putsolardynamics/Telemetry-Module/Docs/Renders/RF_module_3D_render.jpg

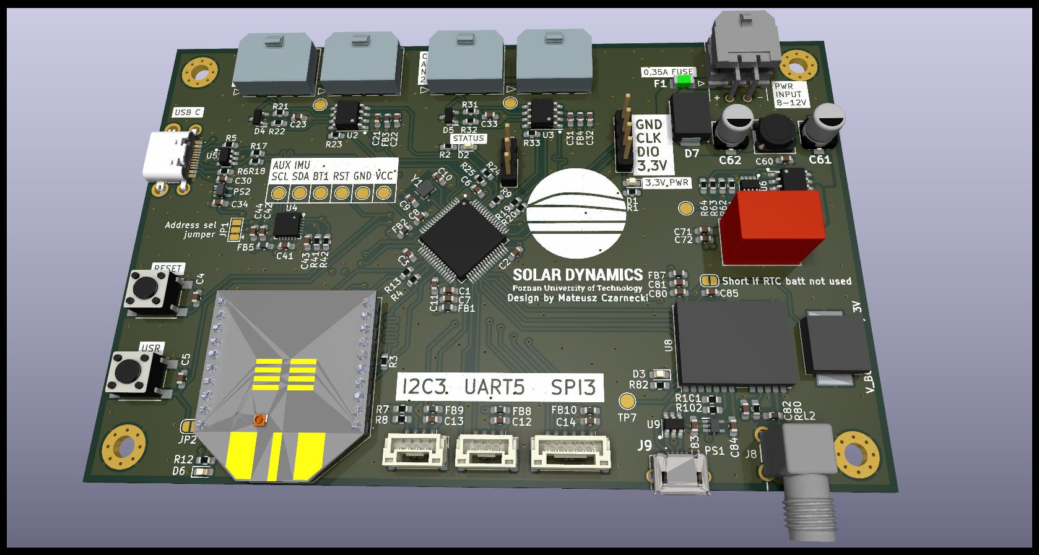
Docs/Renders/RF_module_3D_render.jpg
