putsolardynamics/Telemetry-Module/Docs/Renders/RF_module_2D_back.jpg

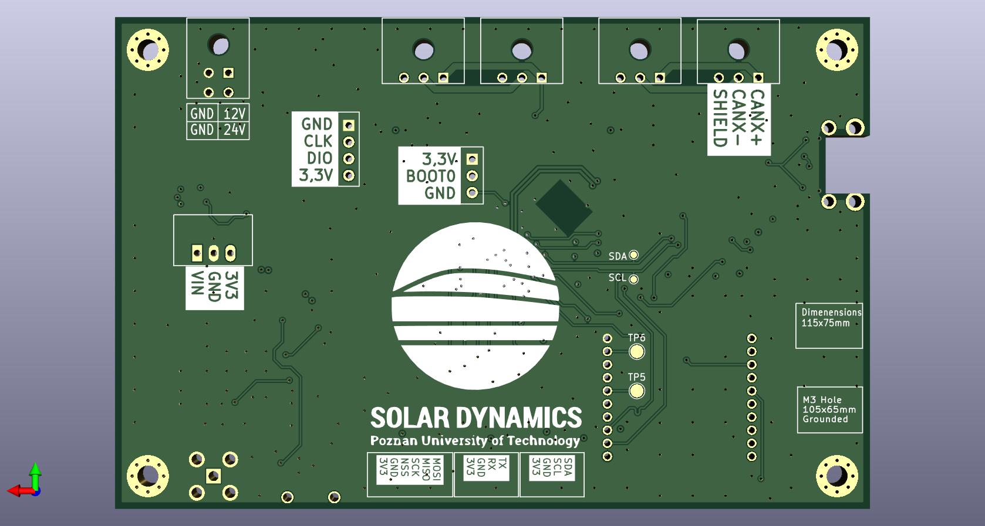
Docs/Renders/RF_module_2D_back.jpg
