putsolardynamics/Telemetry-Module/Docs/Renders/RF_module_2D_front.jpg

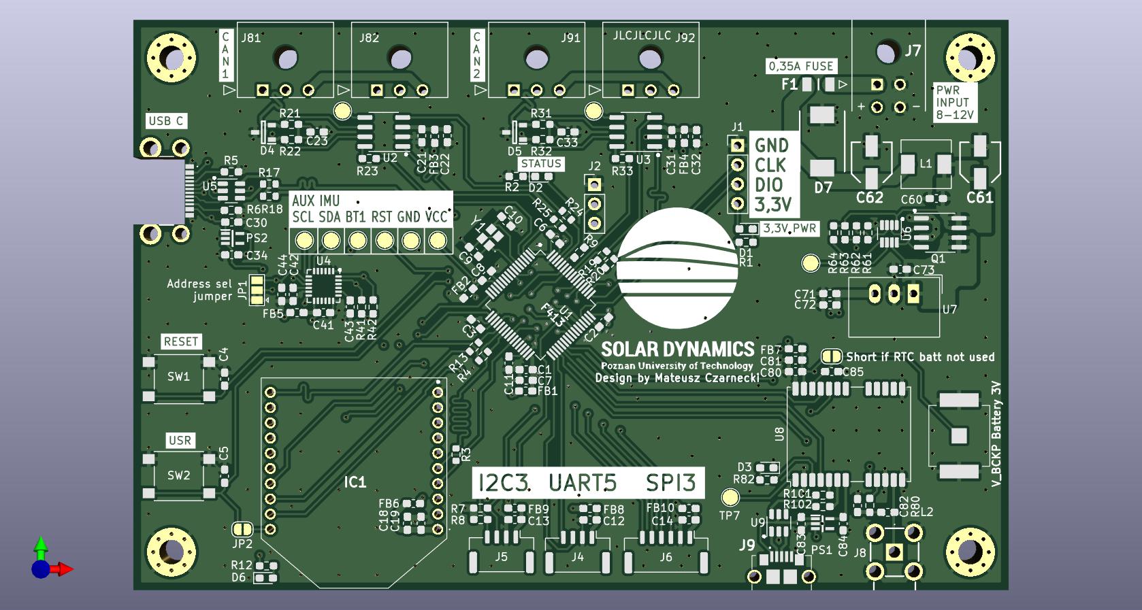
Docs/Renders/RF_module_2D_front.jpg
