putsolardynamics/Telemetry-Module/Docs/Schematics/RF_module.pdf

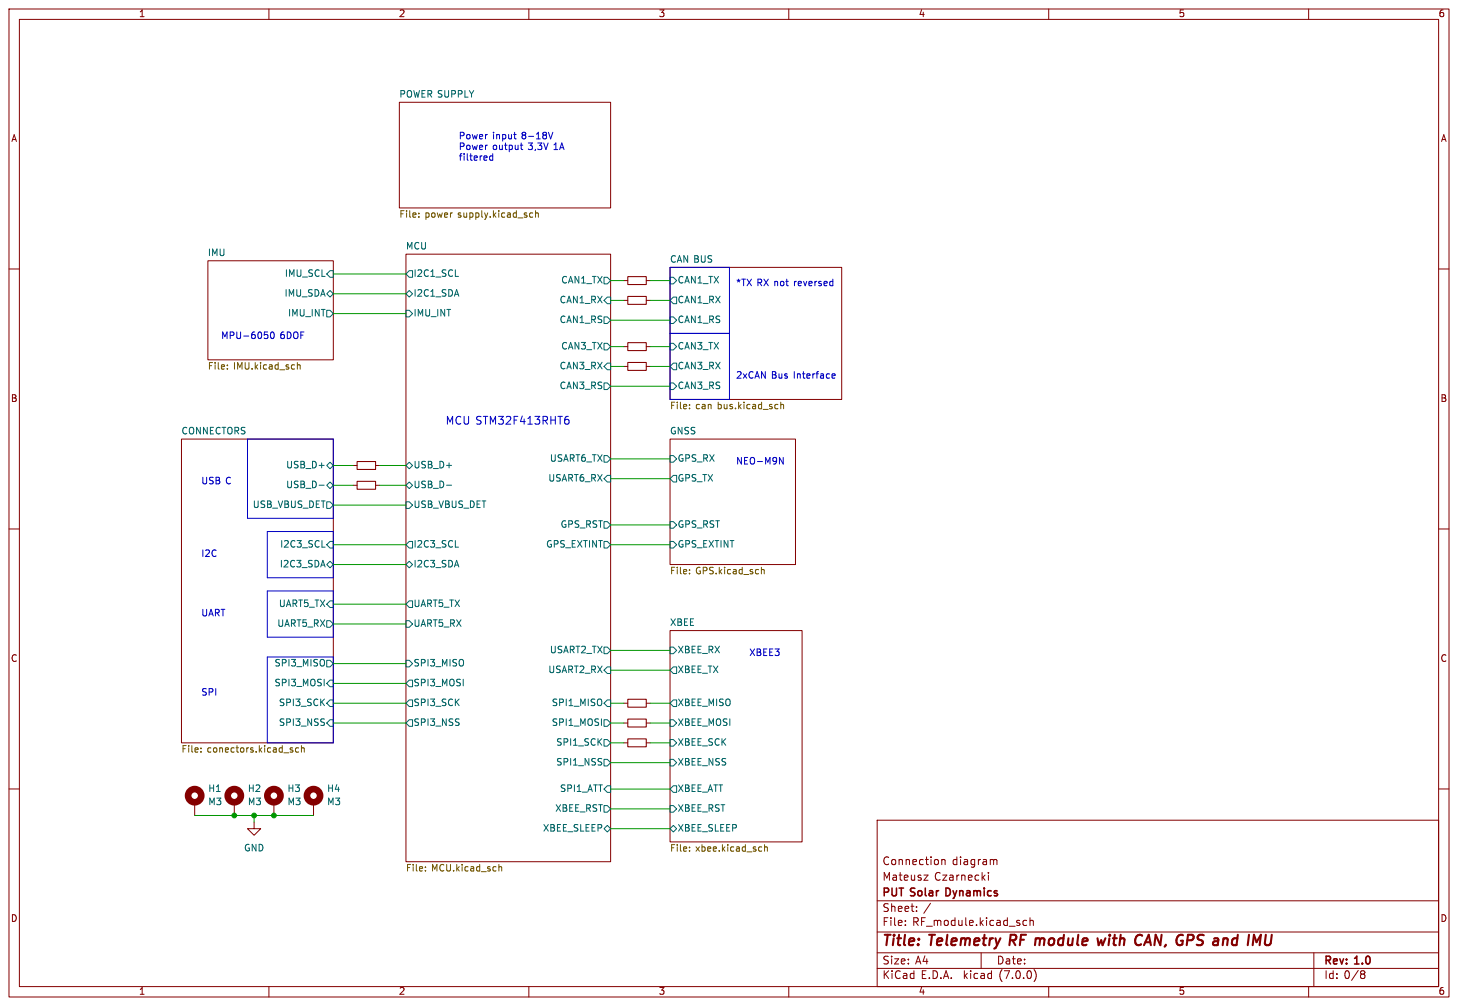
[picture p4: page 1]

File: can bus.kicad_sch POWER SUPPLY

*TX RX not reversed Power input 8-18V
Power output 3,3V 1A
SPI3_NSS USB_D+ UART5_TX UART5_RX MCU
File: GPS.kicad_sch CAN1_RS CAN1_RX CAN1_TX CAN3_RS CAN3_RX CAN3_TX CAN BUS
CAN3_TX CAN1_RX CAN1_TX CAN3_RX

2xCAN Bus Interface MCU STM32F413RHT6 UART SPI
I2C3_SCL USB_D+ USB_D- SPI3_MISO

Id: 0/8 Title: Telemetry RF module with CAN, GPS and IMU

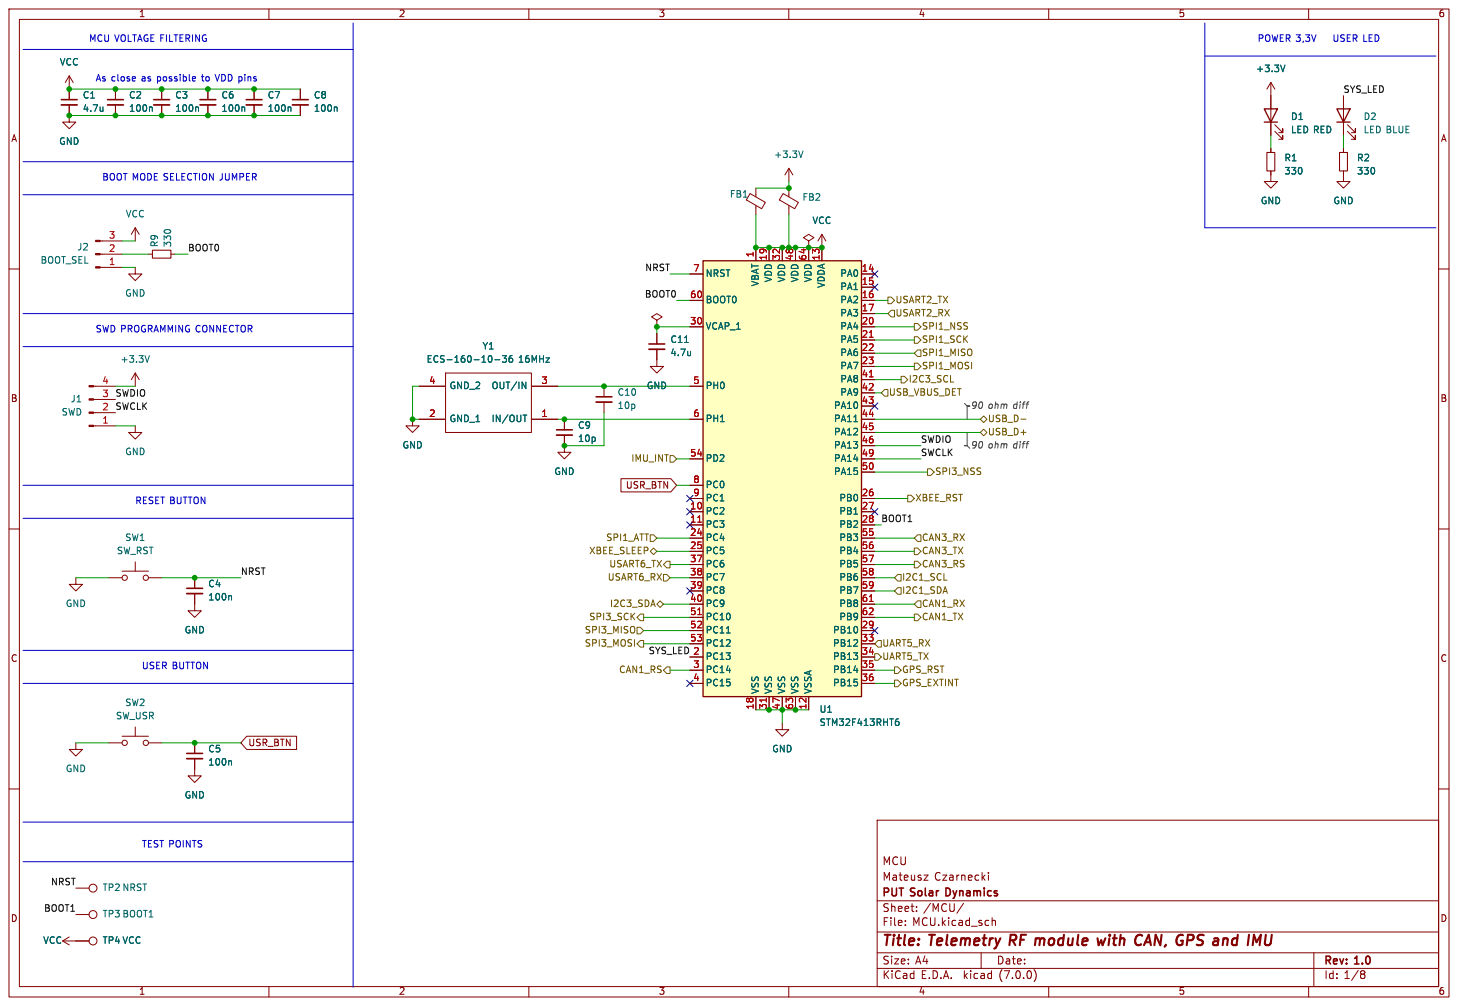
[picture p5: page 2]

BOOT MODE SELECTION JUMPER MCU VOLTAGE FILTERING
100n GND

As close as possible to VDD pins SWD PROGRAMMING CONNECTOR

1 PC2 10 PC3 11 VSSA 12 VDDA 13 PA0 14 PA1 15 PA2 16 PA3 17 VSS 18 VDD 19 PC13 2 PA4 20 PA5 21 PA6 22 PA7 23 PC4 24 PC5 25 PB0 26 PB1 27 PB2 28 PB10 29 PC14 3 VCAP_1 30 VSS 31 VDD 32 PB12 33 PB13 34 PB14 35 PB15 36 PC6 37 PC7 38 PC8 39 PC15 4 PC9 40 PA8 41 PA9 42 PA10 43 PA11 44 PA12 45 PA13 46 VSS 47 VDD 48 PA14 49 PH0 5 PA15 50 PC10 51 PC11 52 PC12 53 PD2 54 PB3 55 PB4 56 PB5 57 PB6 58 PB7 59 PH1 6 BOOT0 60 PB8 61 PB9 62 VSS 63 VDD 64 NRST 7 PC0 8 PC1 9 U1STM32F413RHT6 +3.3V GND

1 PC2 10 PC3 11 VSSA 12 VDDA 13 PA0 14 PA1 15 PA2 16 PA3 17 VSS 18 VDD 19 PC13 2 PA4 20 PA5 21 PA6 22 PA7 23 PC4 24 PC5 25 PB0 26 PB1 27 PB2 28 PB10 29 PC14 3 VCAP_1 30 VSS 31 VDD 32 PB12 33 PB13 34 PB14 35 PB15 36 PC6 37 PC7 38 PC8 39 PC15 4 PC9 40 PA8 41 PA9 42 PA10 43 PA11 44 PA12 45 PA13 46 VSS 47 VDD 48 PA14 49 PH0 5 PA15 50 PC10 51 PC11 52 PC12 53 PD2 54 PB3 55 PB4 56 PB5 57 PB6 58 PB7 59 PH1 6 BOOT0 60 PB8 61 PB9 62 VSS 63 VDD 64 NRST 7 PC0 8 PC1 9 C9

Id: 1/8 Title: Telemetry RF module with CAN, GPS and IMU

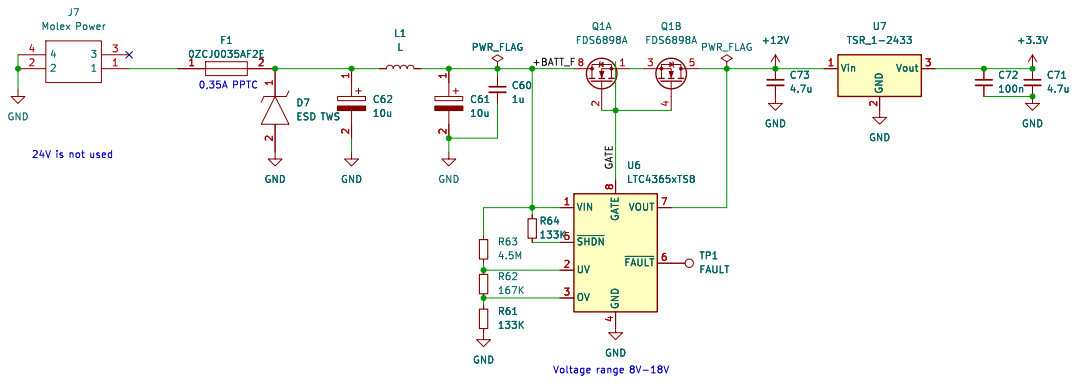
[picture p6: page 3]

4 ~{SHDN} 5 ~{FAULT}6 VOUT 7 GATE

Id: 2/8 Title: Telemetry RF module with CAN, GPS and IMU

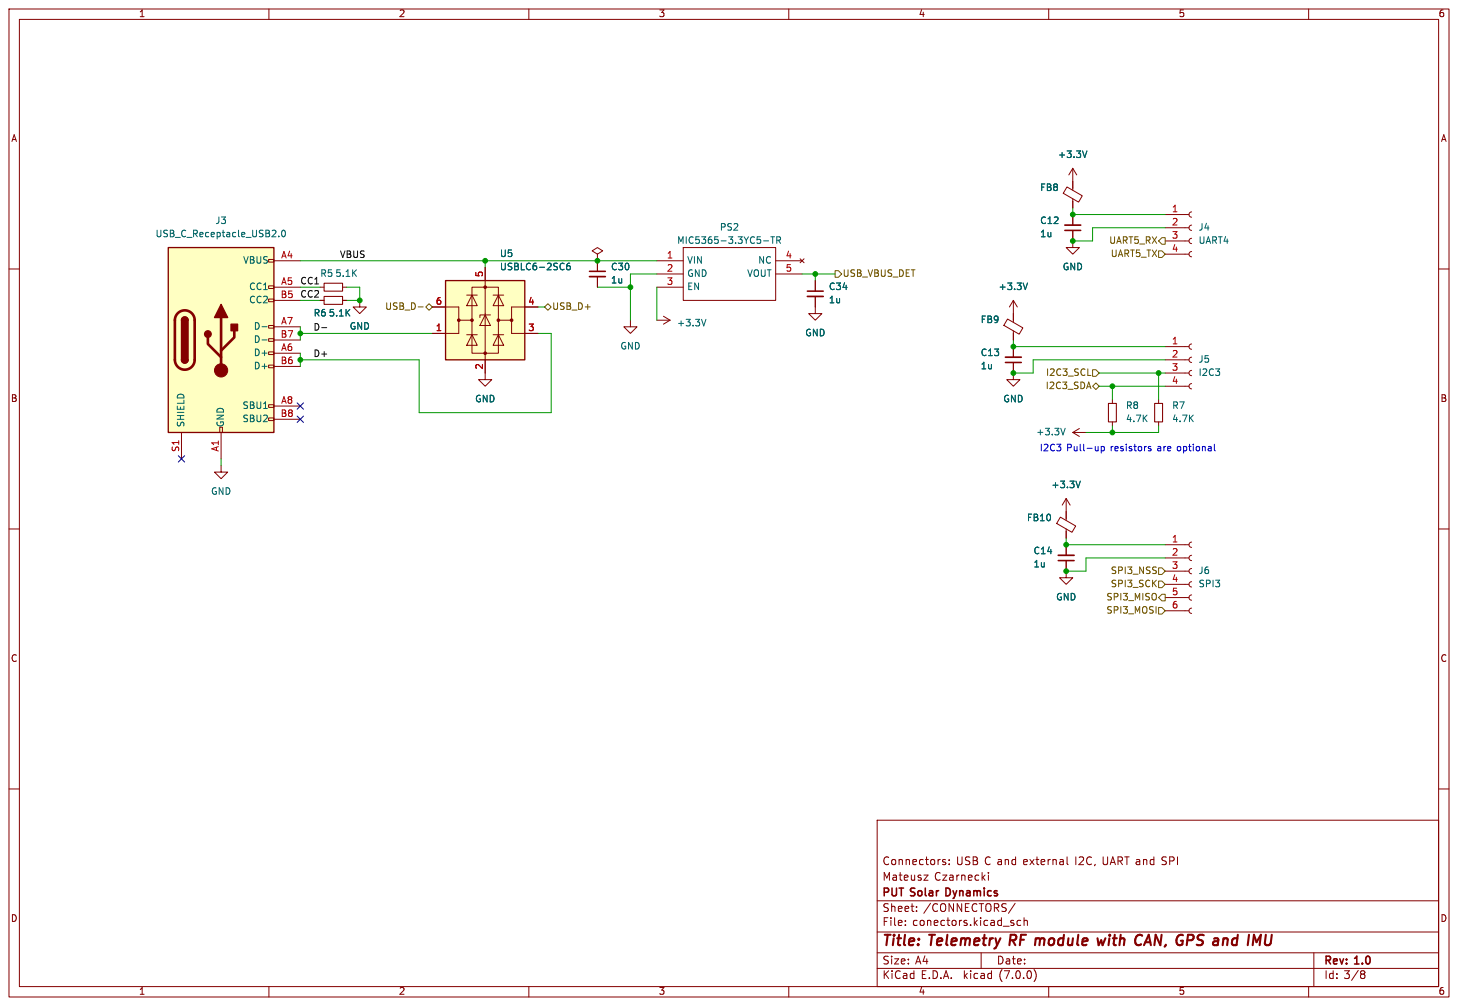
[picture p7: page 4]

Id: 3/8 Title: Telemetry RF module with CAN, GPS and IMU

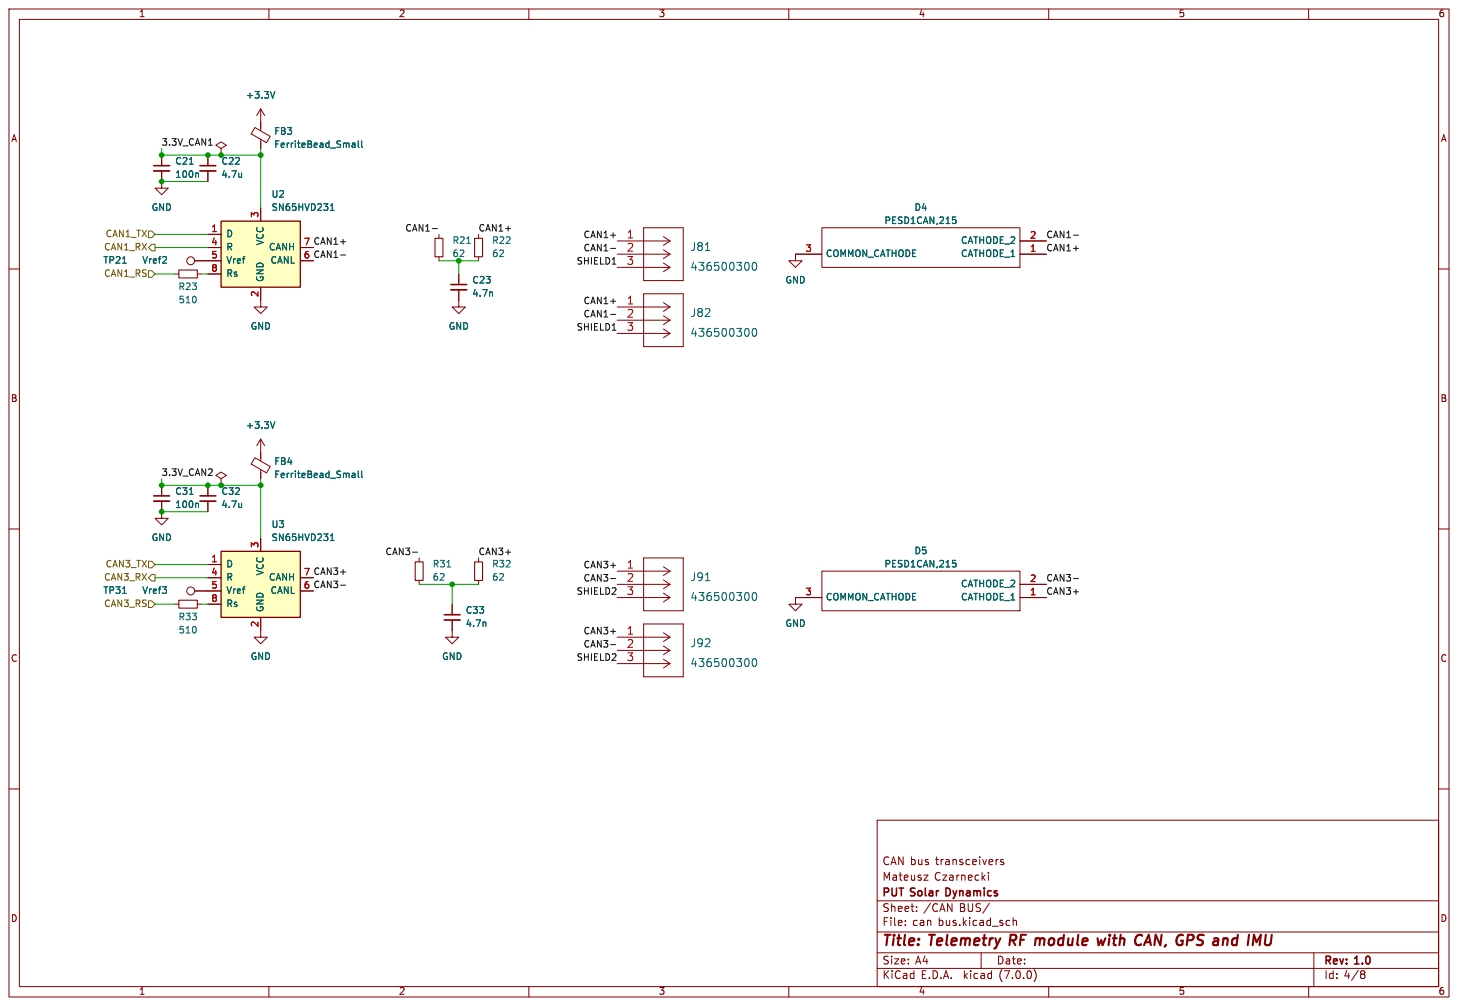
[picture p8: page 5]

Id: 4/8 Title: Telemetry RF module with CAN, GPS and IMU

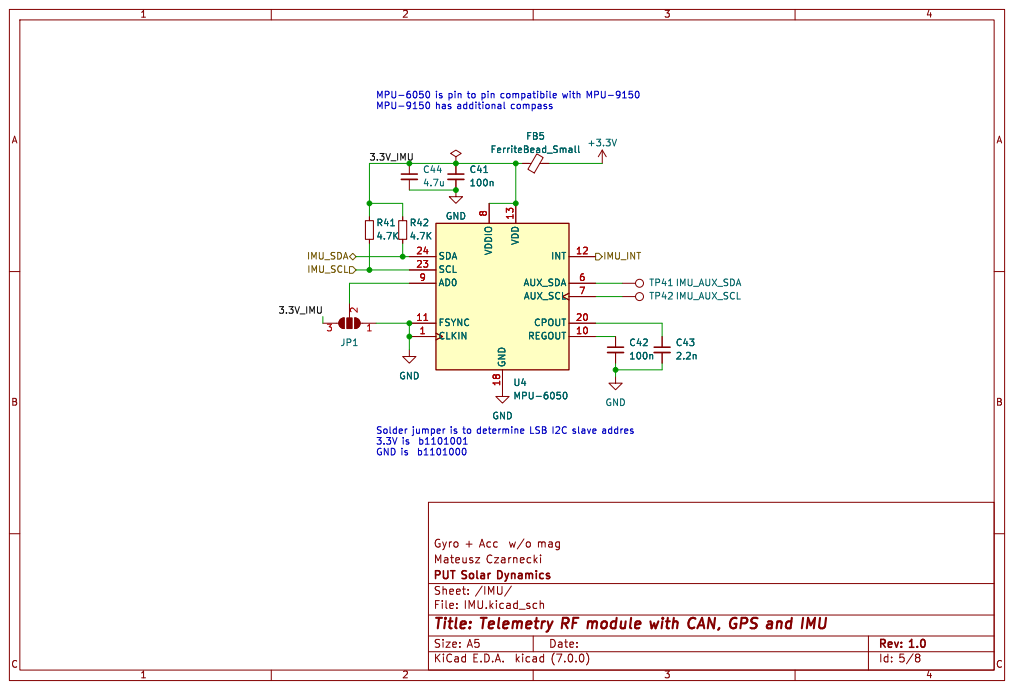
[picture p9: page 6]

Id: 5/8 Title: Telemetry RF module with CAN, GPS and IMU

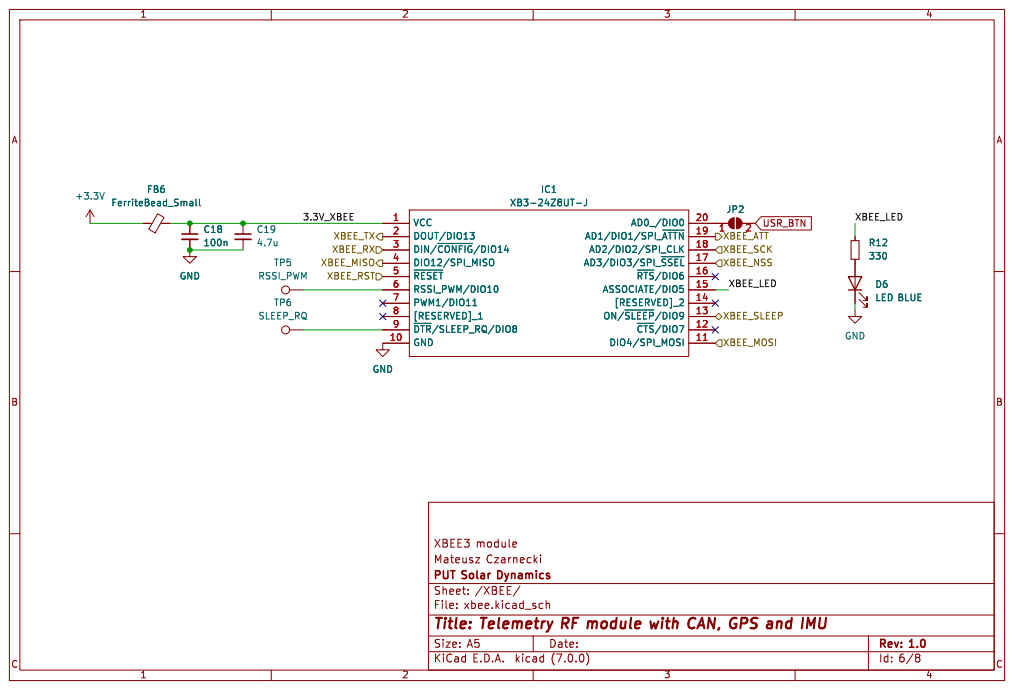
[picture p10: page 7]

Id: 6/8 Title: Telemetry RF module with CAN, GPS and IMU

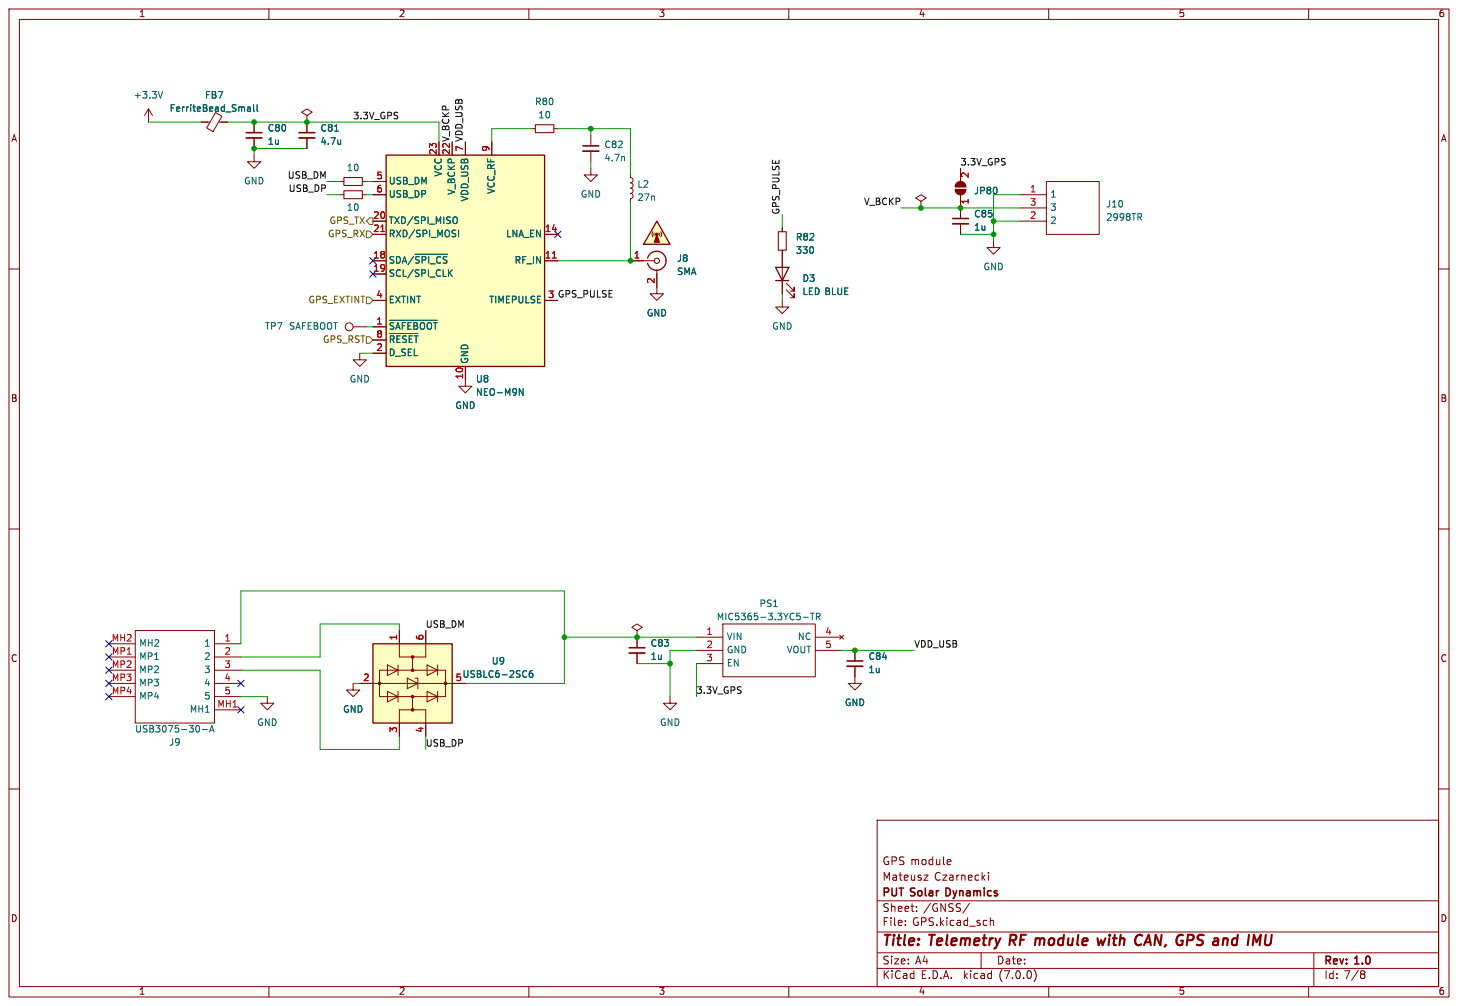
[picture p11: page 8]

Id: 7/8 Title: Telemetry RF module with CAN, GPS and IMU
