putsolardynamics/Telemetry-Module/Hardware/RF_module/RF_module.kicad_pcb

## KiCad design Hardware/RF_module/RF_module.kicad_pcb (2023-03-06)

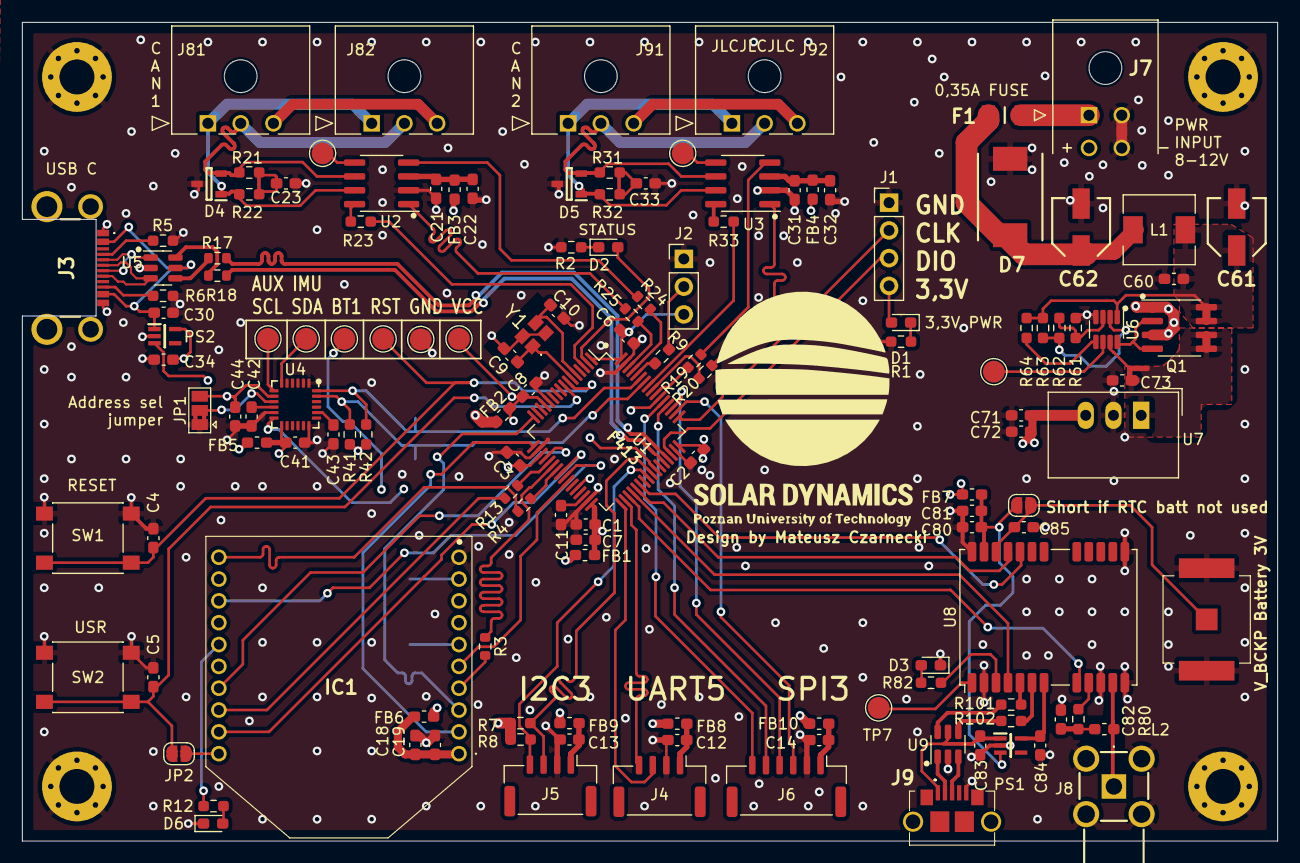
[picture p12: board RF_module.kicad_pcb from above]

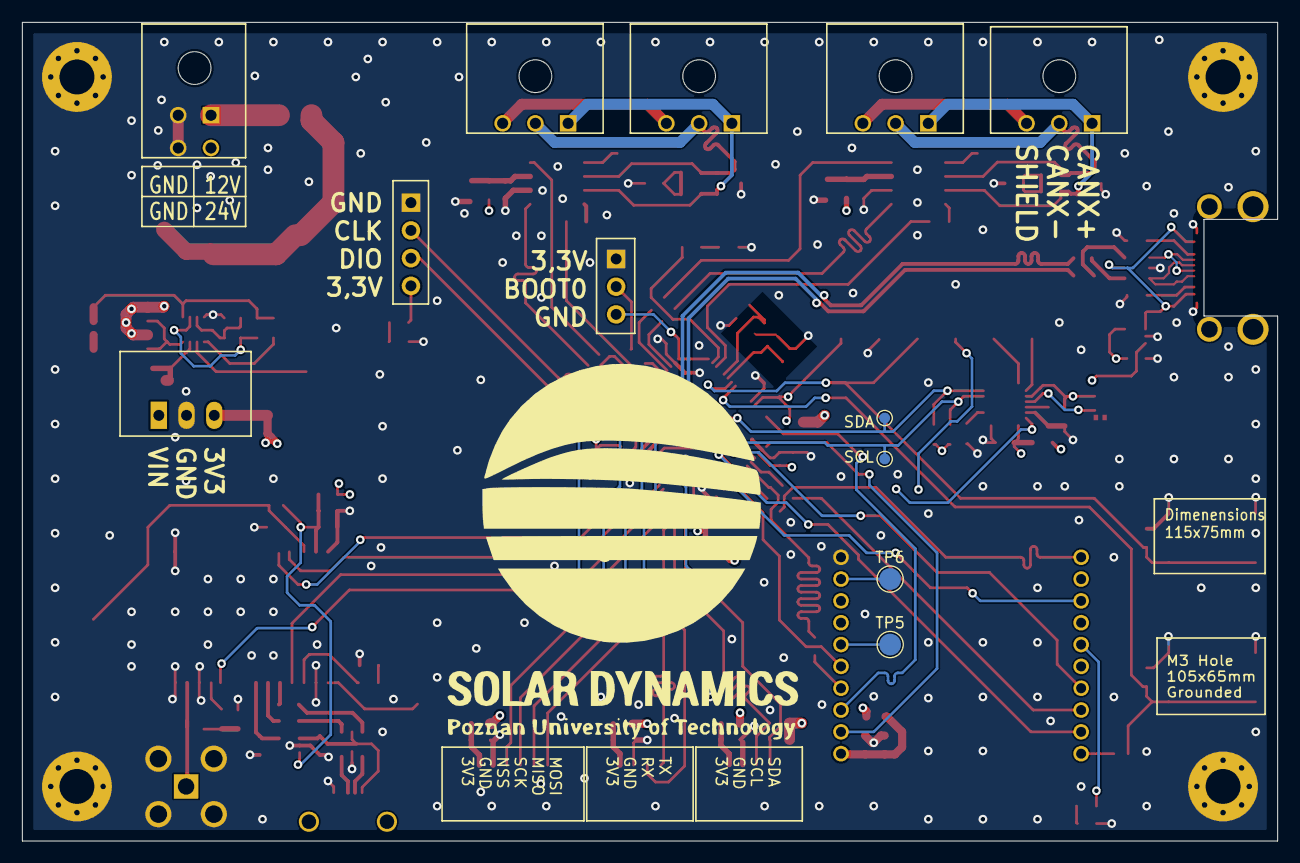
[picture p13: board RF_module.kicad_pcb from below]

Board: 4 copper layers, 115.0 x 75.0 mm, 144 parts (4 on the bottom side), 118 nets.

Parts:
C1, C11, C19, C22, C32, C44, C71, C73, C81: 4.7u; C_0603_1608Metric_Pad1.08x0.95mm_HandSolder
C2, C3, C4, C5, C6, C7, C8, C18, C21, C31, C41, C42, C72: 100n; C_0603_1608Metric_Pad1.08x0.95mm_HandSolder
C9, C10: 10p; C_0603_1608Metric_Pad1.08x0.95mm_HandSolder
C12, C13, C14, C30, C34, C60, C80, C83, C84, C85: 1u; C_0603_1608Metric_Pad1.08x0.95mm_HandSolder
C23, C33, C82: 4.7n; C_0603_1608Metric_Pad1.08x0.95mm_HandSolder
C43: 2.2n; C_0603_1608Metric_Pad1.08x0.95mm_HandSolder
C61, C62: 10u; EEE0GA101SR
D1: LED RED; LED_0603_1608Metric_Pad1.05x0.95mm_HandSolder
D2, D3, D6: LED BLUE; LED_0603_1608Metric_Pad1.05x0.95mm_HandSolder
D4, D5: PESD1CAN,215; SOT95P230X110-3N
D7: ESD TWS; DIONM7959X262N
F1: 0ZCJ0035AF2E; FUSC3216X130N
FB1, FB2, FB3, FB4, FB5, FB6, FB7, FB8, FB9, FB10: FerriteBead_Small; L_0603_1608Metric_Pad1.05x0.95mm_HandSolder
H1, H2, H3, H4: M3; MountingHole_3.2mm_M3_Pad_Via
IC1: XB3-24Z8UT-J; XB324Z8UTJ
J1: SWD; PinHeader_1x04_P2.54mm_Vertical
J2: BOOT_SEL; PinHeader_1x03_P2.54mm_Vertical
J3: USB_C_Receptacle_USB2.0; USB4500030A
J4: UART4; JST_GH_BM04B-GHS-TBT_1x04-1MP_P1.25mm_Vertical
J5: I2C3; JST_GH_BM04B-GHS-TBT_1x04-1MP_P1.25mm_Vertical
J6: SPI3; JST_GH_BM06B-GHS-TBT_1x06-1MP_P1.25mm_Vertical
J7: Molex Power; 43045-04_00,01,02,10_
J8: SMA; 518144002
J9: USB3075-30-A; USB307530A
J10: 2998TR
J81, J82, J91, J92: 436500300
JP1: SolderJumper_3_Open; SolderJumper-3_P1.3mm_Bridged2Bar12_Pad1.0x1.5mm
JP2, JP80: SolderJumper_2_Open; SolderJumper-2_P1.3mm_Open_RoundedPad1.0x1.5mm
L1: L; L_6.3x6.3_H3
L2: 27n; L_0603_1608Metric_Pad1.05x0.95mm_HandSolder
PS1, PS2: MIC5365-3.3YC5-TR; SOT65P210X110-5N
Q1: FDS6898A; SOIC-8_3.9x4.9mm_P1.27mm
R1, R2, R9, R12, R82: 330; R_0603_1608Metric_Pad0.98x0.95mm_HandSolder
R3, R4, R13, R17, R18, R19, R20, R24, R25: 0; R_0603_1608Metric
R5, R6: 5.1K; R_0603_1608Metric_Pad0.98x0.95mm_HandSolder
R7, R8, R41, R42: 4.7K; R_0603_1608Metric_Pad0.98x0.95mm_HandSolder
R21, R22, R31, R32: 62; R_0603_1608Metric_Pad0.98x0.95mm_HandSolder
R23, R33: 510; R_0603_1608Metric_Pad0.98x0.95mm_HandSolder
R61, R64: 133K; R_0603_1608Metric_Pad0.98x0.95mm_HandSolder
R62: 167K; R_0603_1608Metric_Pad0.98x0.95mm_HandSolder
R63: 4.5M; R_0603_1608Metric_Pad0.98x0.95mm_HandSolder
R80, R101, R102: 10; R_0603_1608Metric_Pad0.98x0.95mm_HandSolder
SW1: SW_RST; SW_Push_1P1T_NO_6x6mm_H9.5mm
SW2: SW_USR; SW_Push_1P1T_NO_6x6mm_H9.5mm
TP1: FAULT; TestPoint_Pad_D2.0mm
TP2: NRST; TestPoint_Pad_D2.0mm
TP3: BOOT1; TestPoint_Pad_D2.0mm
TP4: VCC; TestPoint_Pad_D2.0mm
TP5: RSSI_PWM; TestPoint_Pad_D2.0mm
TP6: SLEEP_RQ; TestPoint_Pad_D2.0mm
TP7: SAFEBOOT; TestPoint_Pad_D2.0mm
TP21: Vref2; TestPoint_Pad_D2.0mm
TP31: Vref3; TestPoint_Pad_D2.0mm
TP41: IMU_AUX_SDA; TestPoint_Pad_D2.0mm
TP42: IMU_AUX_SCL; TestPoint_Pad_D2.0mm
TP234: GND; TestPoint_Pad_D2.0mm
TP_SDA: TestPoint_Pad_D1.0mm
TP_SDA#2: TestPoint_Pad_D1.0mm
U1: STM32F413RHT6; LQFP-64_10x10mm_P0.5mm
U2, U3: SN65HVD231; SOIC-8_3.9x4.9mm_P1.27mm
U4: MPU-6050; InvenSense_QFN-24_4x4mm_P0.5mm
U5, U9: USBLC6-2SC6; SOT-23-6
U6: LTC4365xTS8; TSOT-23-8
U7: TSR_1-2433; Converter_DCDC_TRACO_TSR-1_THT
U8: NEO-M9N; ublox_NEO
Y1: ECS-160-10-36 16MHz; ECS1601036CKMTR3

Connections:
+3.3V: C71.1, C72.1, D1.2 (A), FB1.1, FB2.1, FB3.1, FB4.1, FB5.2, FB6.1, FB7.1, FB8.1, FB9.1, FB10.1, J1.4, PS2.3 (EN), R7.1, R8.1, U7.3 (Vout)
+12V: C73.1, Q1.5 (D2), Q1.6 (D2), U6.7 (VOUT), U7.1 (Vin)
/CAN BUS/3.3V_CAN1: C21.1, C22.1, FB3.2, U2.3 (VCC)
/CAN BUS/3.3V_CAN2: C31.1, C32.1, FB4.2, U3.3 (VCC)
/CAN BUS/CAN1+: D4.1 (CATHODE_1), J81.1, J82.1, R22.1, U2.7 (CANH)
/CAN BUS/CAN1-: D4.2 (CATHODE_2), J81.2, J82.2, R21.1, U2.6 (CANL)
/CAN BUS/CAN1_RS: R23.2, U1.3 (PC14)
/CAN BUS/CAN1_RX: R24.2, U2.4 (R)
/CAN BUS/CAN1_TX: R25.2, U2.1 (D)
/CAN BUS/CAN3+: D5.1 (CATHODE_1), J91.1, J92.1, R32.1, U3.7 (CANH)
/CAN BUS/CAN3-: D5.2 (CATHODE_2), J91.2, J92.2, R31.1, U3.6 (CANL)
/CAN BUS/CAN3_RS: R33.2, U1.57 (PB5)
/CAN BUS/CAN3_RX: R19.2, U3.4 (R)
/CAN BUS/CAN3_TX: R20.2, U3.1 (D)
/CAN BUS/SHIELD1: J81.3, J82.3
/CAN BUS/SHIELD2: J91.3, J92.3
/CONNECTORS/CC1: J3.A5 (CC1), R5.1
/CONNECTORS/CC2: J3.B5 (CC2), R6.1
/CONNECTORS/D+: J3.A6 (D+), J3.B6 (D+), U5.3 (I/O2)
/CONNECTORS/D-: J3.A7 (D-), J3.B7 (D-), U5.1 (I/O1)
/CONNECTORS/I2C3_SCL: J5.3, R7.2, U1.41 (PA8)
/CONNECTORS/I2C3_SDA: J5.4, R8.2, U1.40 (PC9)
/CONNECTORS/SPI3_MISO: J6.5, U1.52 (PC11)
/CONNECTORS/SPI3_MOSI: J6.6, U1.53 (PC12)
/CONNECTORS/SPI3_NSS: J6.3, U1.50 (PA15)
/CONNECTORS/SPI3_SCK: J6.4, U1.51 (PC10)
/CONNECTORS/UART5_RX: J4.3, U1.33 (PB12)
/CONNECTORS/UART5_TX: J4.4, U1.34 (PB13)
/CONNECTORS/USB_D+: R17.1, U5.4 (I/O2)
/CONNECTORS/USB_D-: R18.1, U5.6 (I/O1)
/CONNECTORS/USB_VBUS_DET: C34.1, PS2.5 (VOUT), U1.42 (PA9)
/CONNECTORS/VBUS: C30.1, J3.A4 (VBUS), J3.A9 (VBUS), PS2.1 (VIN), U5.5 (VBUS)
/GNSS/3.3V_GPS: C80.1, C81.1, FB7.2, JP80.2 (B), PS1.3 (EN), U8.23 (VCC)
/GNSS/GPS_EXTINT: U1.36 (PB15), U8.4 (EXTINT)
/GNSS/GPS_PULSE: R82.1, U8.3 (TIMEPULSE)
/GNSS/GPS_RST: U1.35 (PB14), U8.8 (~RESET)
/GNSS/GPS_RX: U1.37 (PC6), U8.21 (RXD/SPI_MOSI)
/GNSS/GPS_TX: U1.38 (PC7), U8.20 (TXD/SPI_MISO)
/GNSS/USB_DM: R101.1, U9.6 (I/O1)
/GNSS/USB_DP: R102.1, U9.4 (I/O2)
/GNSS/VDD_USB: C84.1, PS1.5 (VOUT), U8.7 (VDD_USB)
/GNSS/V_BCKP: C85.1, J10.3, JP80.1 (A), U8.22 (V_BCKP)
/IMU/3.3V_IMU: C41.1, C44.1, FB5.1, JP1.3 (B), R41.1, R42.1, U4.8 (VDDIO), U4.13 (VDD)
/IMU/IMU_INT: U1.54 (PD2), U4.12 (INT)
/IMU/IMU_SCL: R41.2, TP_SDA.1, U1.58 (PB6), U4.23 (SCL)
/IMU/IMU_SDA: R42.2, TP_SDA#2.1, U1.59 (PB7), U4.24 (SDA)
/MCU/BOOT0: R9.2, U1.60 (BOOT0)
/MCU/BOOT1: TP3.1, U1.28 (PB2)
/MCU/CAN1_RX: R24.1, U1.61 (PB8)
/MCU/CAN1_TX: R25.1, U1.62 (PB9)
/MCU/CAN3_RX: R19.1, U1.55 (PB3)
/MCU/CAN3_TX: R20.1, U1.56 (PB4)
/MCU/NRST: C4.1, SW1.2, TP2.1, U1.7 (NRST)
/MCU/SPI1_ATT: IC1.19 (AD1/DIO1/SPI_~ATTN), U1.24 (PC4)
/MCU/SPI1_MISO: R3.1, U1.22 (PA6)
/MCU/SPI1_MOSI: R4.1, U1.23 (PA7)
/MCU/SPI1_NSS: IC1.17 (AD3/DIO3/SPI_~SSEL), U1.20 (PA4)
/MCU/SPI1_SCK: R13.1, U1.21 (PA5)
/MCU/SWCLK: J1.2, U1.49 (PA14)
/MCU/SWDIO: J1.3, U1.46 (PA13)
/MCU/SYS_LED: D2.2 (A), U1.2 (PC13)
/MCU/USART2_RX: IC1.2 (DOUT/DIO13), U1.17 (PA3)
/MCU/USART2_TX: IC1.3 (DIN/~CONFIG/DIO14), U1.16 (PA2)
/MCU/USB_D+: R17.2, U1.45 (PA12)
/MCU/USB_D-: R18.2, U1.44 (PA11)
/MCU/XBEE_RST: IC1.5 (~RESET), U1.26 (PB0)
/MCU/XBEE_SLEEP: IC1.13 (ON/~SLEEP/DIO9), U1.25 (PC5)
/POWER SUPPLY/+BATT_F: C60.1, C61.1, L1.2, Q1.7 (D1), Q1.8 (D1), R63.1, R64.1, U6.1 (VIN)
/POWER SUPPLY/GATE: Q1.2 (G1), Q1.4 (G2), U6.8 (GATE)
/XBEE/3.3V_XBEE: C18.1, C19.1, FB6.2, IC1.1 (VCC)
/XBEE/XBEE_LED: IC1.15 (ASSOCIATE/DIO5), R12.1
/XBEE/XBEE_MISO: IC1.4 (DIO12/SPI_MISO), R3.2
/XBEE/XBEE_MOSI: IC1.11 (DIO4/SPI_MOSI), R4.2
/XBEE/XBEE_SCK: IC1.18 (AD2/DIO2/SPI_CLK), R13.2
GND: C1.2, C2.2, C3.2, C4.2, C5.2, C6.2, C7.2, C8.2, C9.2, C10.2, C11.2, C12.1, C13.1, C14.1, C18.2, C19.2, C21.2, C22.2, C23.2, C30.2, C31.2, C32.2, C33.2, C34.2, C41.2, C42.2, C43.2, C44.2, C60.2, C61.2, C62.2, C71.2, C72.2, C73.2, C80.2, C81.2, C82.2, C83.2, C84.2, C85.2, D3.1 (K), D4.3 (COMMON_CATHODE), D5.3 (COMMON_CATHODE), D6.1 (K), D7.2, H1.1, H2.1, H3.1, H4.1, IC1.10 (GND), J1.1, J2.1, J3.A1 (GND), J3.A12 (GND), J4.2, J5.2, J6.2, J7.2, J7.4, J8.2 (Ext), J9.5, J10.1, J10.2, JP1.1 (A), PS1.2 (GND), PS2.2 (GND), R1.2, R2.2, R5.2, R6.2, R61.2, SW1.1, SW2.1, TP234.1, U1.12 (VSSA), U1.18 (VSS), U1.31 (VSS), U1.47 (VSS), U1.63 (VSS), U2.2 (GND), U3.2 (GND), U4.1 (CLKIN), U4.11 (FSYNC), U4.18 (GND), U5.2 (GND), U6.4 (GND), U7.2 (GND), U8.2 (D_SEL), U8.10 (GND), U8.12 (GND), U8.13 (GND), U8.24 (GND), U9.2 (GND), Y1.2 (GND_1), Y1.4 (GND_2)
unnamed: C23.1, R21.2, R22.2
unnamed: C33.1, R31.2, R32.2
unnamed: C62.1, D7.1, F1.2, L1.1
unnamed: C82.1, L2.1, R80.2
unnamed: D1.1 (K), R1.1
unnamed: D2.1 (K), R2.1
unnamed: D3.2 (A), R82.2
unnamed: D6.2 (A), R12.2
unnamed: F1.1, J7.1
unnamed: IC1.20 (AD0_/DIO0), JP2.1 (A)
unnamed: IC1.6 (RSSI_PWM/DIO10), TP5.1
unnamed: IC1.9 (~DTR/SLEEP_RQ/DIO8), TP6.1
unnamed: J2.2, R9.1
unnamed: C12.2, FB8.2, J4.1
unnamed: C13.2, FB9.2, J5.1
unnamed: C14.2, FB10.2, J6.1
unnamed: J8.1 (In), L2.2, U8.11 (RF_IN)
unnamed: J9.2, U9.1 (I/O1)
unnamed: J9.3, U9.3 (I/O2)
unnamed: JP1.2 (C), U4.9 (AD0)
unnamed: C83.1, J9.1, PS1.1 (VIN), U9.5 (VBUS)
unnamed: Q1.1 (S1), Q1.3 (S2)
unnamed: C10.1, U1.5 (PH0), Y1.3 (OUT/IN)
unnamed: C9.1, U1.6 (PH1), Y1.1 (IN/OUT)
unnamed: C11.1, U1.30 (VCAP_1)
unnamed: R23.1, U2.8 (Rs)
unnamed: TP21.1, U2.5 (Vref)
unnamed: R33.1, U3.8 (Rs)
unnamed: TP31.1, U3.5 (Vref)
unnamed: TP42.1, U4.7 (AUX_SCL)
unnamed: TP41.1, U4.6 (AUX_SDA)
unnamed: C43.1, U4.20 (CPOUT)
unnamed: C42.1, U4.10 (REGOUT)
unnamed: R61.1, R62.1, U6.3 (OV)
unnamed: R62.2, R63.2, U6.2 (UV)
unnamed: TP1.1, U6.6 (~FAULT)
unnamed: R64.2, U6.5 (~SHDN)
unnamed: R101.2, U8.5 (USB_DM)
unnamed: R102.2, U8.6 (USB_DP)
unnamed: R80.1, U8.9 (VCC_RF)
unnamed: TP7.1, U8.1 (~SAFEBOOT)
USR_BTN: C5.1, JP2.2 (B), SW2.2, U1.8 (PC0)
VCC: C1.1, C2.1, C3.1, C6.1, C7.1, C8.1, FB1.2, FB2.2, J2.3, TP4.1, U1.1 (VBAT), U1.13 (VDDA), U1.19 (VDD), U1.32 (VDD), U1.48 (VDD), U1.64 (VDD)
