putsolardynamics/Telemetry-Module/ModuleSoftware/Src/main.c

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
/* Includes ------------------------------------------------------------------*/
#include "main.h"
#include "cmsis_os.h"
#include "can.h"
#include "crc.h"
#include "dma.h"
#include "i2c.h"
#include "spi.h"
#include "tim.h"
#include "usart.h"
#include "usb_device.h"
#include "gpio.h"

/* USER CODE BEGIN Includes */
#include "mpu6050.h"
#include "usbd_cdc_if.h"
/* USER CODE END Includes */


/* USER CODE BEGIN PV */
volatile uint8_t mpuReceiveDone =1;
volatile uint8_t uartTransmitDone=1;
// volatile uint8_t uartReceiveDone=1;
// volatile uint16_t uartReceiveLen;
// extern osMessageQId uartCDCHandle;

/* USER CODE END PV */

void SystemClock_Config(void);
void MX_FREERTOS_Init(void);
/* USER CODE BEGIN PFP */

void HAL_I2C_MemRxCpltCallback (I2C_HandleTypeDef * hi2c){
  if(hi2c->Instance==hi2c1.Instance){
    mpuReceiveDone = 1;
  }
}

void HAL_UART_RxCpltCallback(UART_HandleTypeDef *huart){
  if(huart->Instance==huart2.Instance){
    extern osMessageQId uartCDCHandle;
    static BaseType_t taskWoken;
    for(uint32_t i=0;i<huart->RxXferSize;i++){
      xQueueSendFromISR(uartCDCHandle, huart2.pRxBuffPtr + i,&taskWoken);
    }
    HAL_UART_Receive_DMA(&huart2,huart->pRxBuffPtr,1);
  }
}
void HAL_UART_TxCpltCallback(UART_HandleTypeDef *huart){
  if(huart->Instance==huart2.Instance){
    uartTransmitDone = 1;
  }
}

/* USER CODE END PFP */

/**
  * @brief  The application entry point.
  * @retval int
  */
int main(void)
{

  /* MCU Configuration--------------------------------------------------------*/

  /* Reset of all peripherals, Initializes the Flash interface and the Systick. */
  HAL_Init();

  /* Configure the system clock */
  SystemClock_Config();

  /* Initialize all configured peripherals */
  MX_GPIO_Init();
  MX_DMA_Init();
  MX_CAN1_Init();
  MX_CAN3_Init();
  MX_I2C1_Init();
  MX_I2C3_Init();
  MX_SPI1_Init();
  MX_SPI3_Init();
  MX_UART5_Init();
  MX_USART2_UART_Init();
  MX_USART6_UART_Init();
  MX_CRC_Init();
  MX_TIM6_Init();
  /* USER CODE BEGIN 2 */
  while (MPU6050_Init(&hi2c1) == 1);
  HAL_TIM_Base_Start_IT(&htim6);
  // HAL_UART_Receive_IT(&huart6, &Received, 1);
  
  // gps reset
  HAL_GPIO_WritePin(GPS_RST_GPIO_Port,GPS_RST_Pin, GPIO_PIN_RESET);
  HAL_Delay(200);
  HAL_GPIO_WritePin(GPS_RST_GPIO_Port,GPS_RST_Pin, GPIO_PIN_SET);

  // initialize continuous uart dma read
  // HAL_UART_Receive_DMA(&huart2,uartCDCBuffer,1024);
  
  /* USER CODE END 2 */

  /* Call init function for freertos objects (in cmsis_os2.c) */
  MX_FREERTOS_Init();

  /* Start scheduler */
  osKernelStart();

  /* We should never get here as control is now taken by the scheduler */

  /* Infinite loop */
  /* USER CODE BEGIN WHILE */

  // MX_USB_DEVICE_Init();
  

  while (1)
  {
    /* USER CODE END WHILE */

    /* USER CODE BEGIN 3 */
  }
  /* USER CODE END 3 */
}

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
/**
  * @brief  Period elapsed callback in non blocking mode
  * @note   This function is called  when TIM10 interrupt took place, inside
  * HAL_TIM_IRQHandler(). It makes a direct call to HAL_IncTick() to increment
  * a global variable "uwTick" used as application time base.
  * @param  htim : TIM handle
  * @retval None
  */
void HAL_TIM_PeriodElapsedCallback(TIM_HandleTypeDef *htim)
{
  /* USER CODE BEGIN Callback 0 */
  if (htim->Instance == TIM6)
  {
    HAL_GPIO_TogglePin(GPIOC, SYS_LED_Pin);
  }

  /* USER CODE END Callback 0 */
  if (htim->Instance == TIM10) {
    HAL_IncTick();
  }
}

/**
  * @brief  This function is executed in case of error occurrence.
  * @retval None
  */
void Error_Handler(void)
{
  /* USER CODE BEGIN Error_Handler_Debug */
  /* User can add his own implementation to report the HAL error return state */
  __disable_irq();
  while (1)
  {
  }
  /* USER CODE END Error_Handler_Debug */
}

#ifdef  USE_FULL_ASSERT
/**
  * @brief  Reports the name of the source file and the source line number
  *         where the assert_param error has occurred.
  * @param  file: pointer to the source file name
  * @param  line: assert_param error line source number
  * @retval None
  */
void assert_failed(uint8_t *file, uint32_t line)
{
  /* USER CODE BEGIN 6 */
  /* User can add his own implementation to report the file name and line number,
     ex: printf("Wrong parameters value: file %s on line %d\r\n", file, line) */
  /* USER CODE END 6 */
}
#endif /* USE_FULL_ASSERT */
