putsolardynamics/Telemetry-Module/ModuleSoftware/Inc/main.h

#define SYS_LED_Pin GPIO_PIN_13
#define SYS_LED_GPIO_Port GPIOC
#define CAN1_RS_Pin GPIO_PIN_14
#define CAN1_RS_GPIO_Port GPIOC
#define USR_BTN_Pin GPIO_PIN_0
#define USR_BTN_GPIO_Port GPIOC
#define SPI1_ATT_Pin GPIO_PIN_4
#define SPI1_ATT_GPIO_Port GPIOC
#define XBEE_SLEEP_Pin GPIO_PIN_5
#define XBEE_SLEEP_GPIO_Port GPIOC
#define XBEE_RST_Pin GPIO_PIN_0
#define XBEE_RST_GPIO_Port GPIOB
#define GPS_RST_Pin GPIO_PIN_14
#define GPS_RST_GPIO_Port GPIOB
#define GPS_EXTINT_Pin GPIO_PIN_15
#define GPS_EXTINT_GPIO_Port GPIOB
#define GPS_PULSE_Pin GPIO_PIN_8
#define GPS_PULSE_GPIO_Port GPIOC
#define GPS_SEL_Pin GPIO_PIN_10
#define GPS_SEL_GPIO_Port GPIOA
#define IMU_INT_Pin GPIO_PIN_2
#define IMU_INT_GPIO_Port GPIOD
#define CAN3_RS_Pin GPIO_PIN_5
#define CAN3_RS_GPIO_Port GPIOB
