putsolardynamics/Telemetry-Module/Esp32Software/extra_script.py

#/bin/usr/python
import os
Import("env")

# include toolchain paths
env.Replace(COMPILATIONDB_INCLUDE_TOOLCHAIN=True)

# override compilation DB path
env.Replace(COMPILATIONDB_PATH="compile_commands.json")
