putsolardynamics/Telemetry-Module/(commit log)

2023-03-06 Import files
    Initial and probably final revision
    [GPS.kicad_sch, IMU.kicad_sch, MCU.kicad_sch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]
2023-05-05 Add files via upload
    added bom from new generator and pick and place
    [RF_module.csv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]
2023-11-06 Change in toolset to PIO with stm32pio
    How I done it is described on slite
2024-04-23 added flake for stm32pio
2024-04-24 dma tests
2024-08-14 esp32 reciever
