putsolardynamics/Telemetry-Module/(notices)

Notices in the files:
ModuleSoftware/Src/main.c:
Copyright (c) 2023 STMicroelectronics.
All rights reserved.
This software is licensed under terms that can be found in the LICENSE file
ModuleSoftware/Inc/main.h:
Copyright (c) 2024 STMicroelectronics.
parts and their libraries:
Copyright 2021 Accelerated Designs. All rights reserved.
